korandiz/fmtx/board.jpg

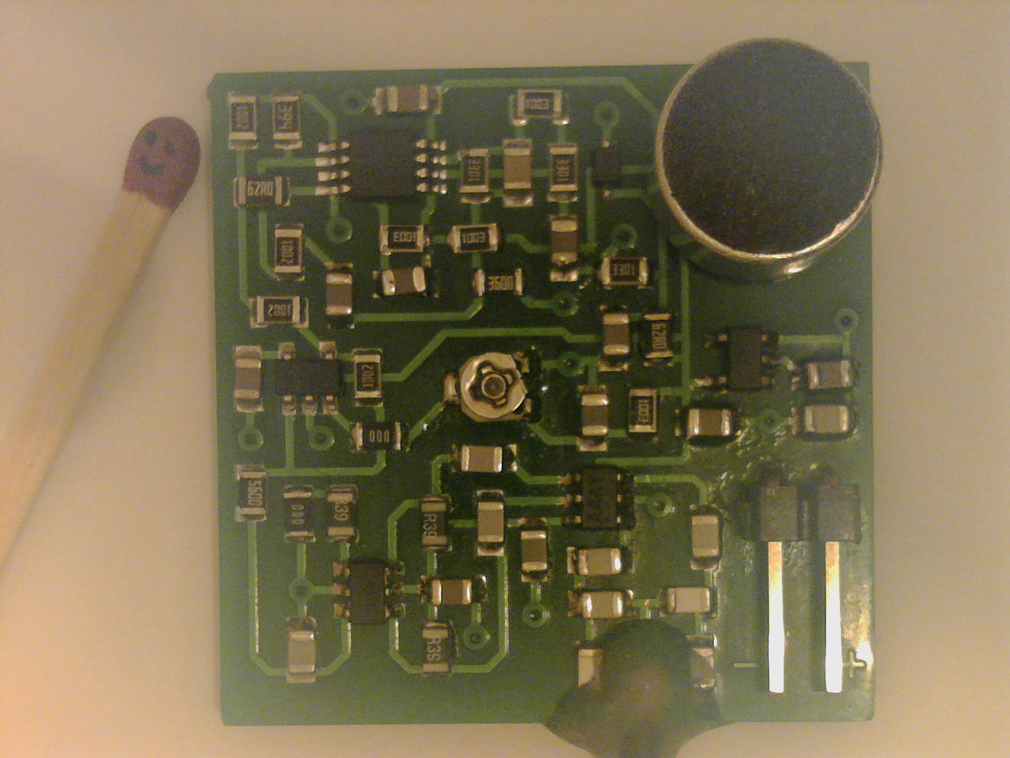
board.jpg
