korandiz/fmtx/schematic.pdf

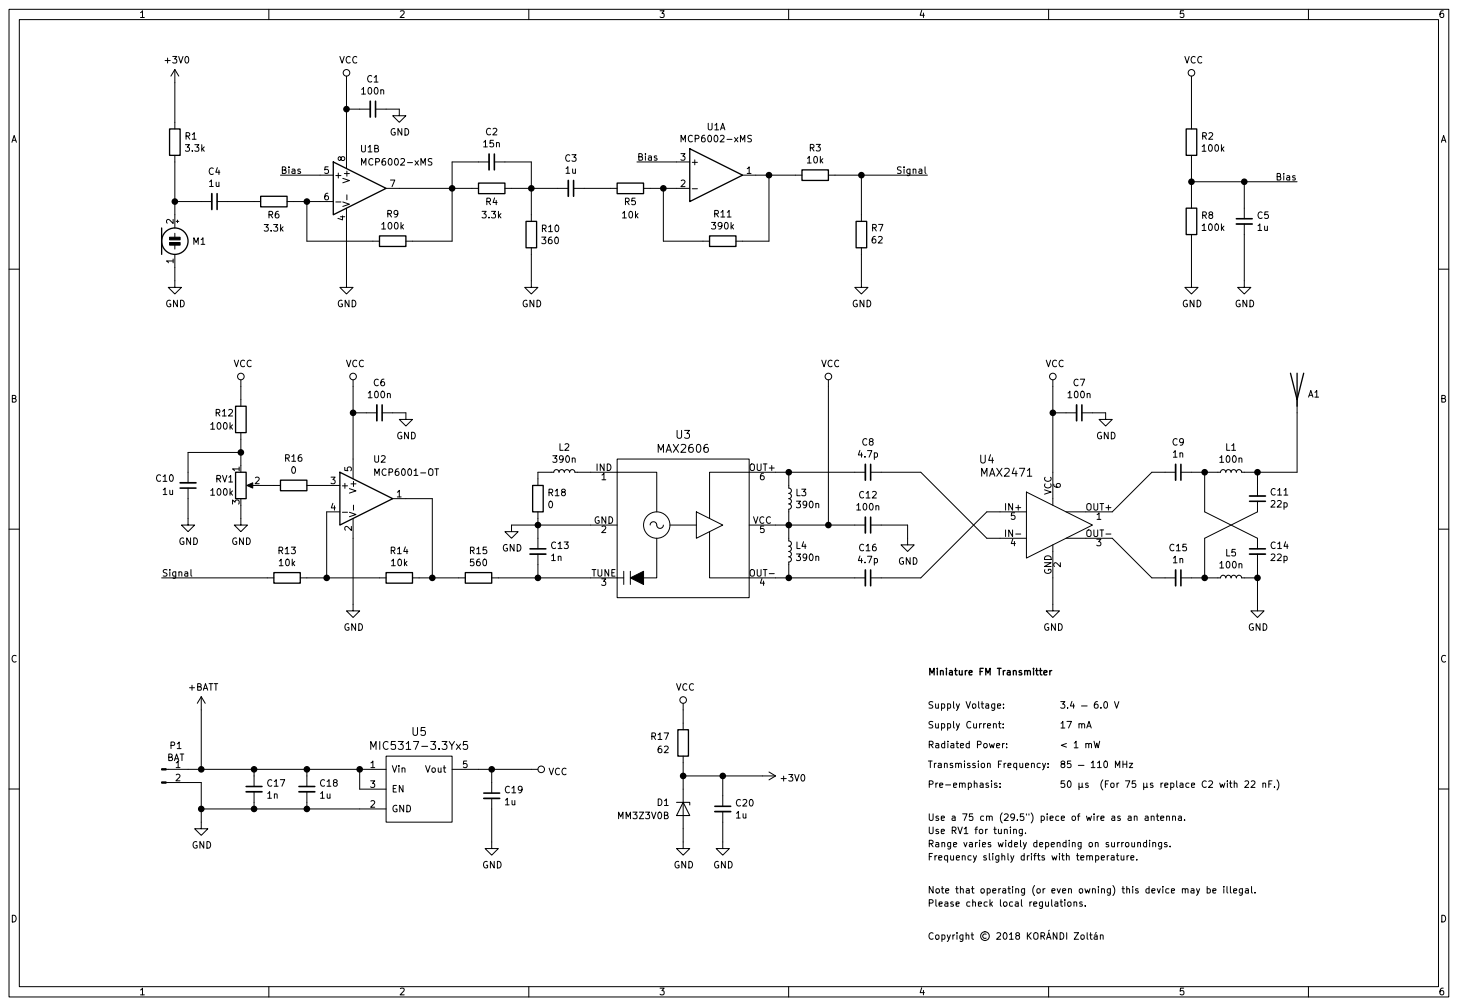
[picture p2: page 1]

Use RV1 for tuning. Miniature FM Transmitter Frequency slighly drifts with temperature.

Range varies widely depending on surroundings.

Note that operating (or even owning) this device may be illegal.
Please check local regulations.
