korandiz/fmtx/assembly.pdf

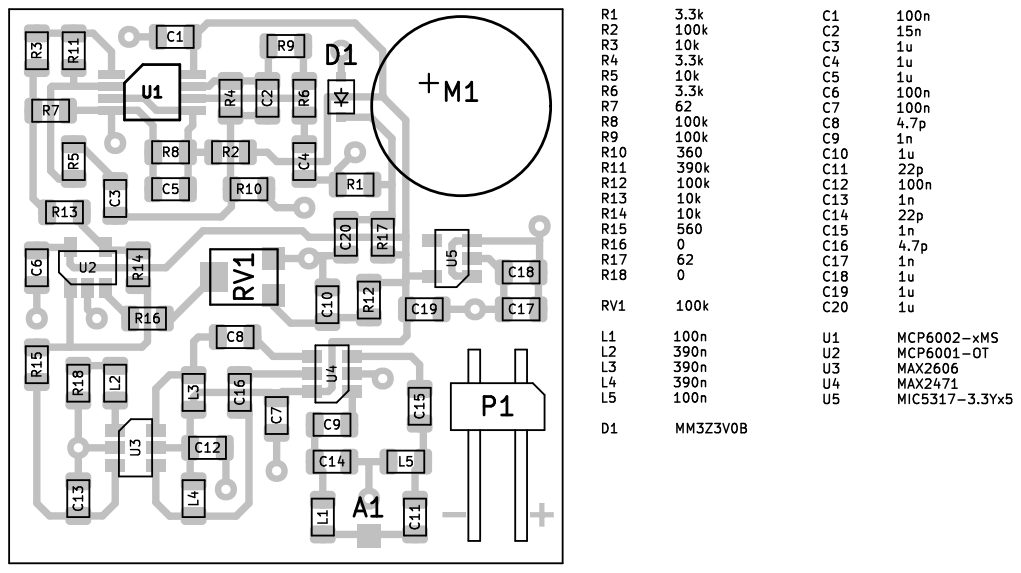
[picture p3: page 1]
