korandiz/fmtx/diy.pdf

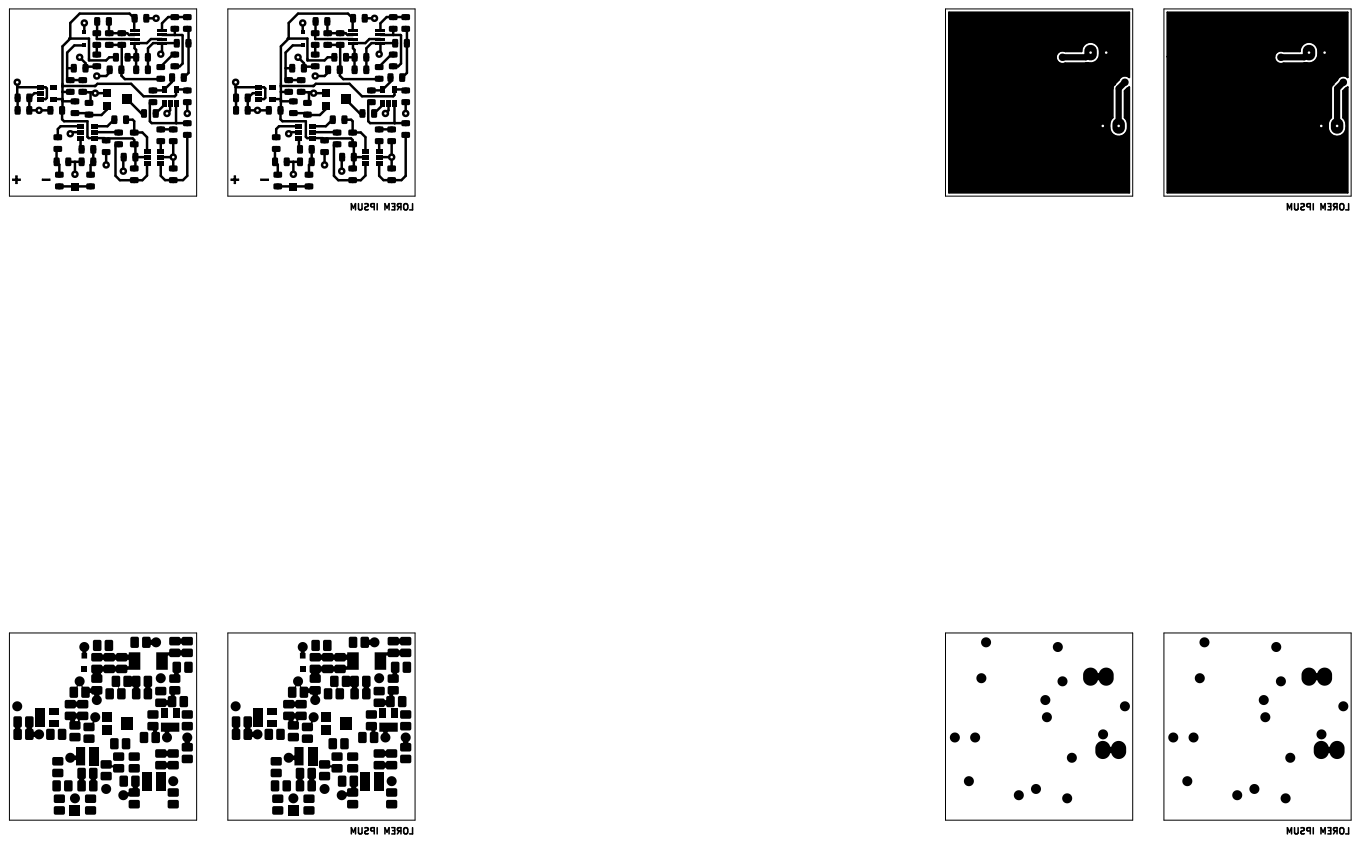
[picture p4: page 1]
