korandiz/fmtx/kicad/bug.kicad_pcb

## KiCad design kicad/bug.kicad_pcb (2019-10-29)

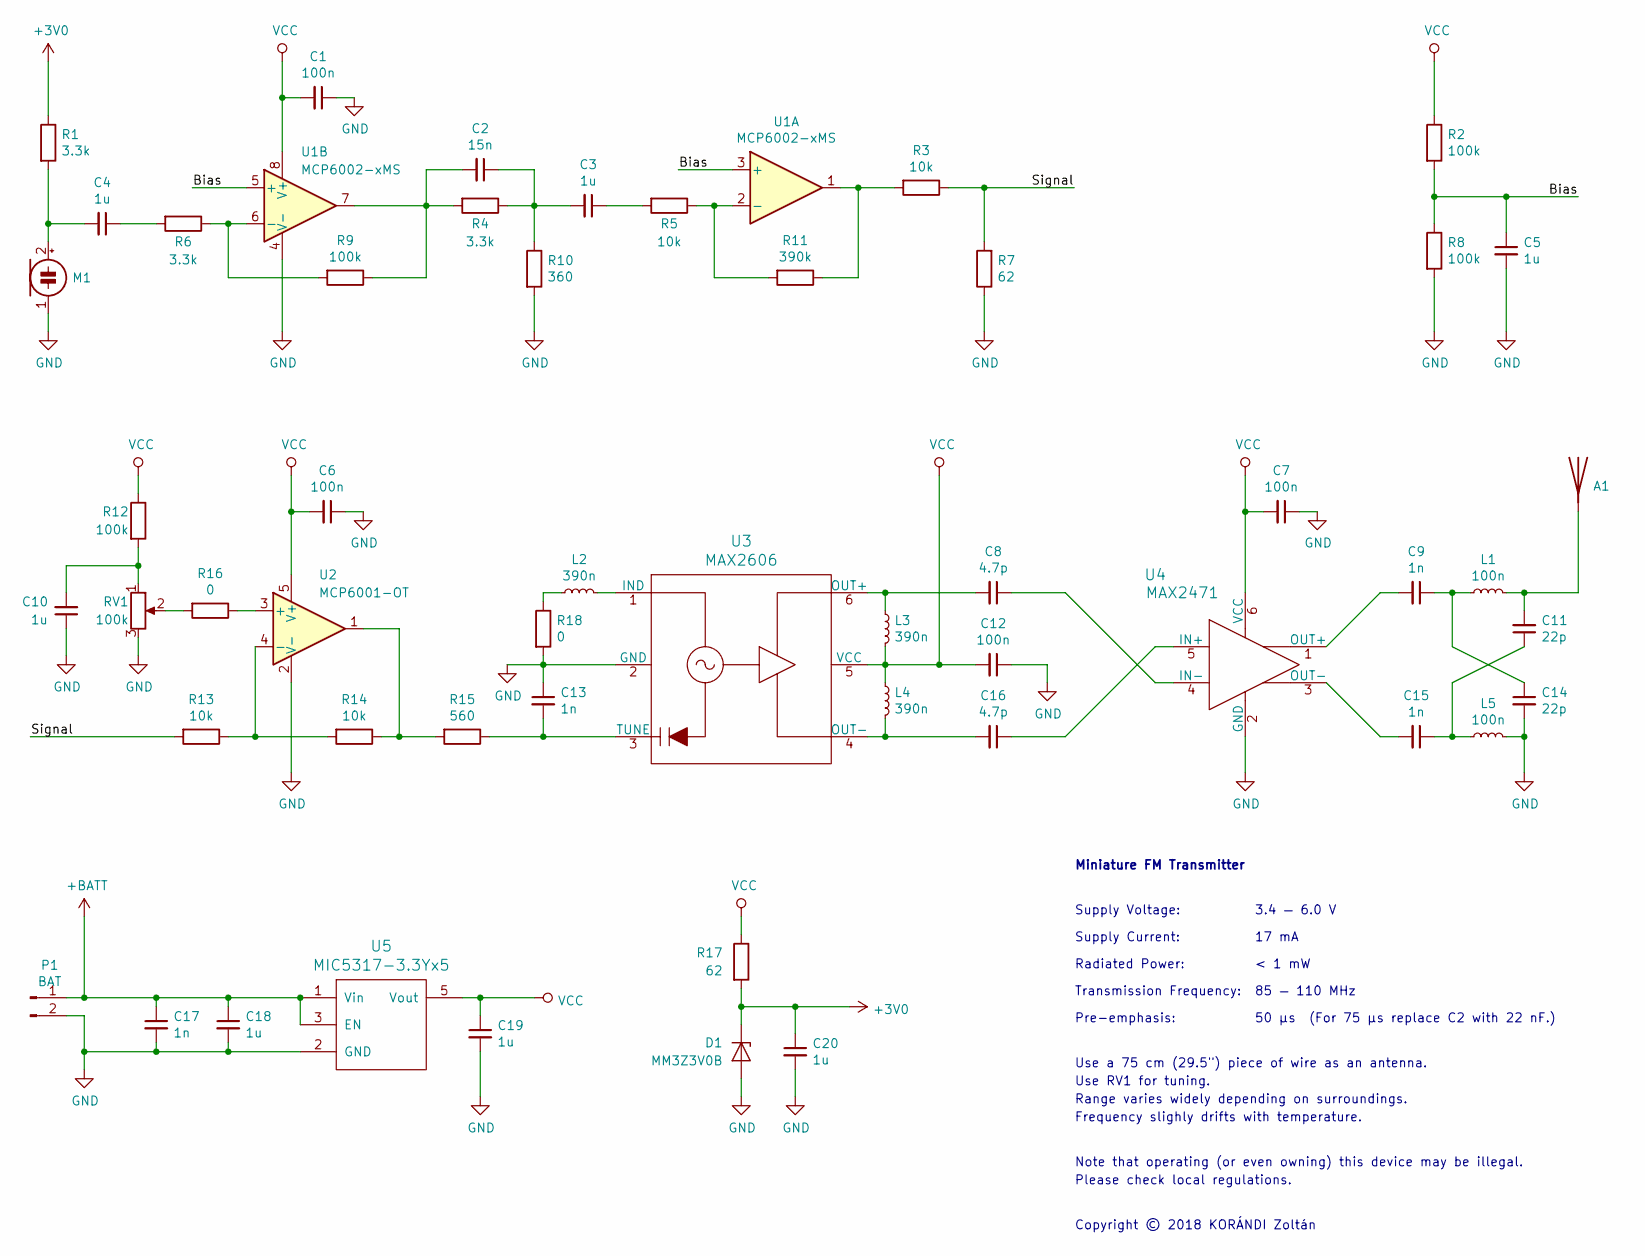
[picture p5: schematic bug.sch]

Parts:
A1: Antenna_Pad
C1, C6, C7, C12: 100n; C_0805_2012Metric
C2: 15n; C_0805_2012Metric
C3, C4, C5, C10, C18, C19, C20: 1u; C_0805_2012Metric
C8, C16: 4.7p; C_0805_2012Metric
C9, C13, C15, C17: 1n; C_0805_2012Metric
C11, C14: 22p; C_0805_2012Metric
D1: MM3Z3V0B; D_SOD-323F
L1, L5: 100n; L_0805_2012Metric
L2, L3, L4: 390n; L_0805_2012Metric
M1: LD-MC-0905P
P1: BAT; PinHeader_1x02_P2.54mm_Horizontal
R1, R4, R6: 3.3k; R_0805_2012Metric
R2, R8, R9, R12: 100k; R_0805_2012Metric
R3, R5, R13, R14: 10k; R_0805_2012Metric
R7, R17: 62; R_0805_2012Metric
R10: 360; R_0805_2012Metric
R11: 390k; R_0805_2012Metric
R15: 560; R_0805_2012Metric
R16, R18: 0; R_0805_2012Metric
RV1: 100k; 35W
U1: MCP6002-xMS; MSOP-8_3x3mm_P0.65mm
U2: MCP6001-OT; SOT-23-5
U3: MAX2606; SOT-23-6
U4: MAX2471; SOT-23-6
U5: MIC5317-3.3Yx5; SOT-23-5

Connections:
+3V0: C20.1, D1.1 (K), R1.1, R17.2
+BATT: C17.1, C18.1, P1.1, U5.1 (Vin), U5.3 (EN)
/Bias: C5.1, R2.2, R8.1, U1.3 (+), U1.5 (+)
/Signal: R3.1, R7.2, R13.2
GND: C1.1, C5.2, C6.1, C7.1, C10.1, C12.1, C13.1, C14.2, C17.2, C18.2, C19.2, C20.2, D1.2 (A), L5.2, M1.1 (-), P1.2, R7.1, R8.2, R10.2, R18.2, RV1.3, U1.4 (V-), U2.2 (V-), U3.2 (GND), U4.2 (GND), U5.2 (GND)
unnamed: A1.1, C11.2, L1.2
unnamed: C2.1, C3.2, R4.1, R10.1
unnamed: C2.2, R4.2, R9.1, U1.7
unnamed: C3.1, R5.2
unnamed: C4.1, R6.2
unnamed: C4.2, M1.2 (+), R1.2
unnamed: C8.1, U4.4 (IN-)
unnamed: C8.2, L3.1, U3.6 (OUT+)
unnamed: C9.2, U4.1 (OUT+)
unnamed: C10.2, R12.2, RV1.1
unnamed: C11.1, C15.1, L5.1
unnamed: C13.2, R15.1, U3.3 (TUNE)
unnamed: C9.1, C14.1, L1.1
unnamed: C15.2, U4.3 (OUT-)
unnamed: C16.1, U4.5 (IN+)
unnamed: C16.2, L4.2, U3.4 (OUT-)
unnamed: L2.1, R18.1
unnamed: L2.2, U3.1 (IND)
unnamed: R6.1, R9.2, U1.6 (-)
unnamed: R3.2, R11.1, U1.1
unnamed: R5.1, R11.2, U1.2 (-)
unnamed: R13.1, R14.2, U2.4 (-)
unnamed: R14.1, R15.2, U2.1
unnamed: R16.1, U2.3 (+)
unnamed: R16.2, RV1.2
VCC: C1.2, C6.2, C7.2, C12.2, C19.1, L3.2, L4.1, R2.1, R12.1, R17.1, U1.8 (V+), U2.5 (V+), U3.5 (VCC), U4.6 (VCC), U5.5 (Vout)

Notes on the sheet:
Supply Voltage:
Supply Current:
Radiated Power:
Transmission Frequency:
85 — 110 MHz
3.4 — 6.0 V
17 mA
< 1 mW
Range varies widely depending on surroundings.
Frequency slighly drifts with temperature.
Use a 75 cm (29.5") piece of wire as an antenna.
Miniature FM Transmitter
Use RV1 for tuning.
50 μs
Pre-emphasis:
Note that operating (or even owning) this device may be illegal.
Please check local regulations.
Copyright © 2018 KORÁNDI Zoltán
(For 75 μs replace C2 with 22 nF.)

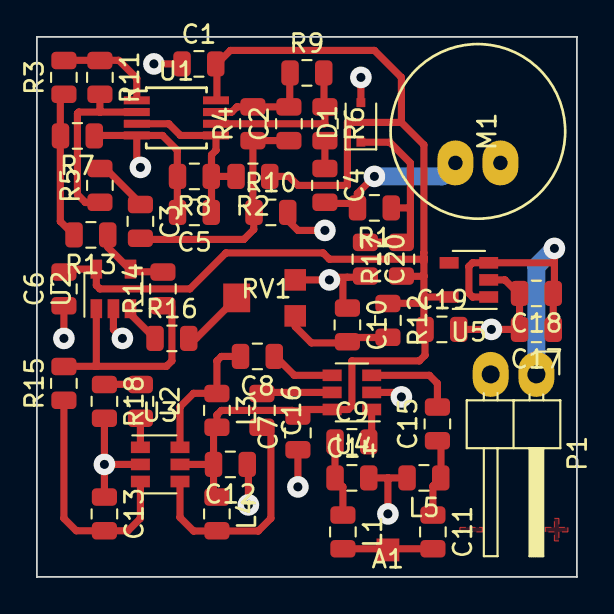
[picture p6: board bug.kicad_pcb from above]

Board: 2 copper layers, 30.0 x 30.0 mm, 53 parts (0 on the bottom side), 31 nets.
