korandiz/fmtx/tests/with_microphone/H.png

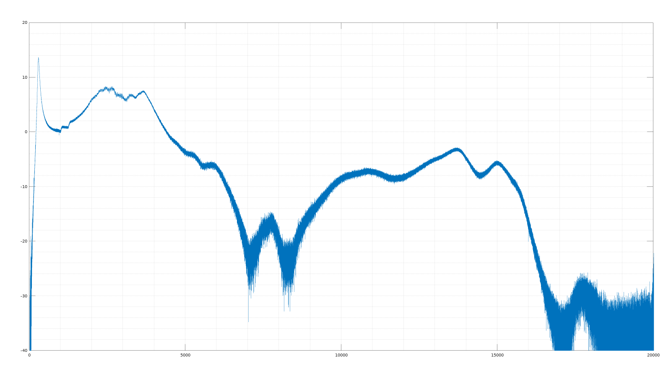
tests/with_microphone/H.png
