korandiz/fmtx/tests/with_microphone/sine_1k.png

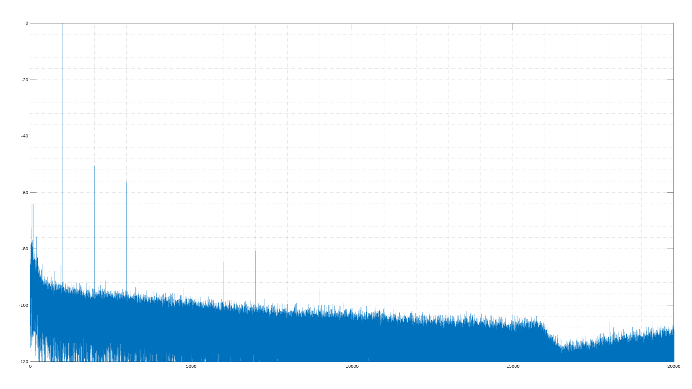
tests/with_microphone/sine_1k.png
