korandiz/fmtx/tests/without_microphone/sine_1k/Y.png

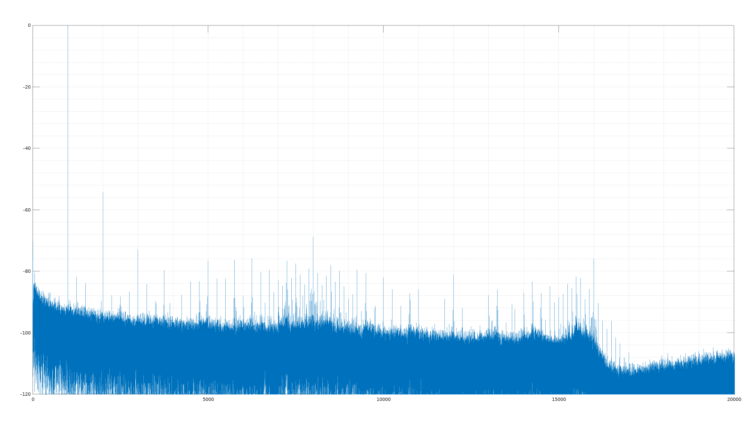
tests/without_microphone/sine_1k/Y.png
