korandiz/fmtx/tests/without_microphone/sweep_20-20k/H.png

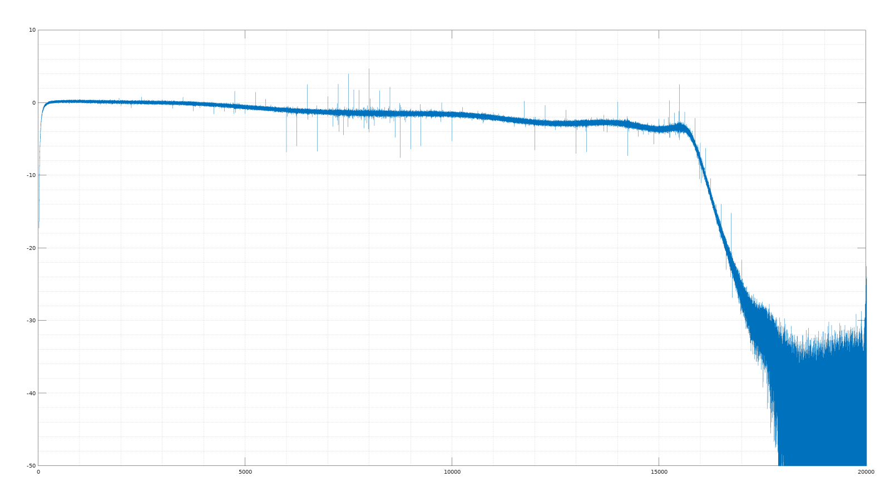
tests/without_microphone/sweep_20-20k/H.png
